SingingSinking/Analog-chip-tester-leti/README.md

# Analog-chip-tester-leti
  Подробная инструкция по эксплуатации устройства предназначеного для тестирования работоспособности по трём критериям аналоговых микросхем: операционных усилителей (OPA2134, UA4721), аналоговых умножителей (AD633-DIP, AD633-SOIC) и инструментальных усилителей. (AD8221, AD620) на Arduino.
