SingingSinking/Analog-chip-tester-leti/(commit log)

2024-06-07 Main-Firmware
    Прошивка для Arduino
2024-06-07 Инструкция к устройству
2024-06-07 Firmware.ino
    Прошивка Arduino
